ucisolarcar/Power-Switching-CAN-Prototype/(commit log)

2024-06-28 Init commit with code and docs
    Need to fix and add links to the documentation
    [MEGA_Lib_Test.ino, esp32_receive_lib_test.ino]
2024-06-28 Rename CANBUS & Power Switching Prototype Documentation.md to README
